ETechZone/Smart-Power-Bank/README.md

# Smart-Power-Bank
my current project in reewo
