ETechZone/Smart-Power-Bank/supporting_docs/F28027_PCBfiles/Station Lower.pdf

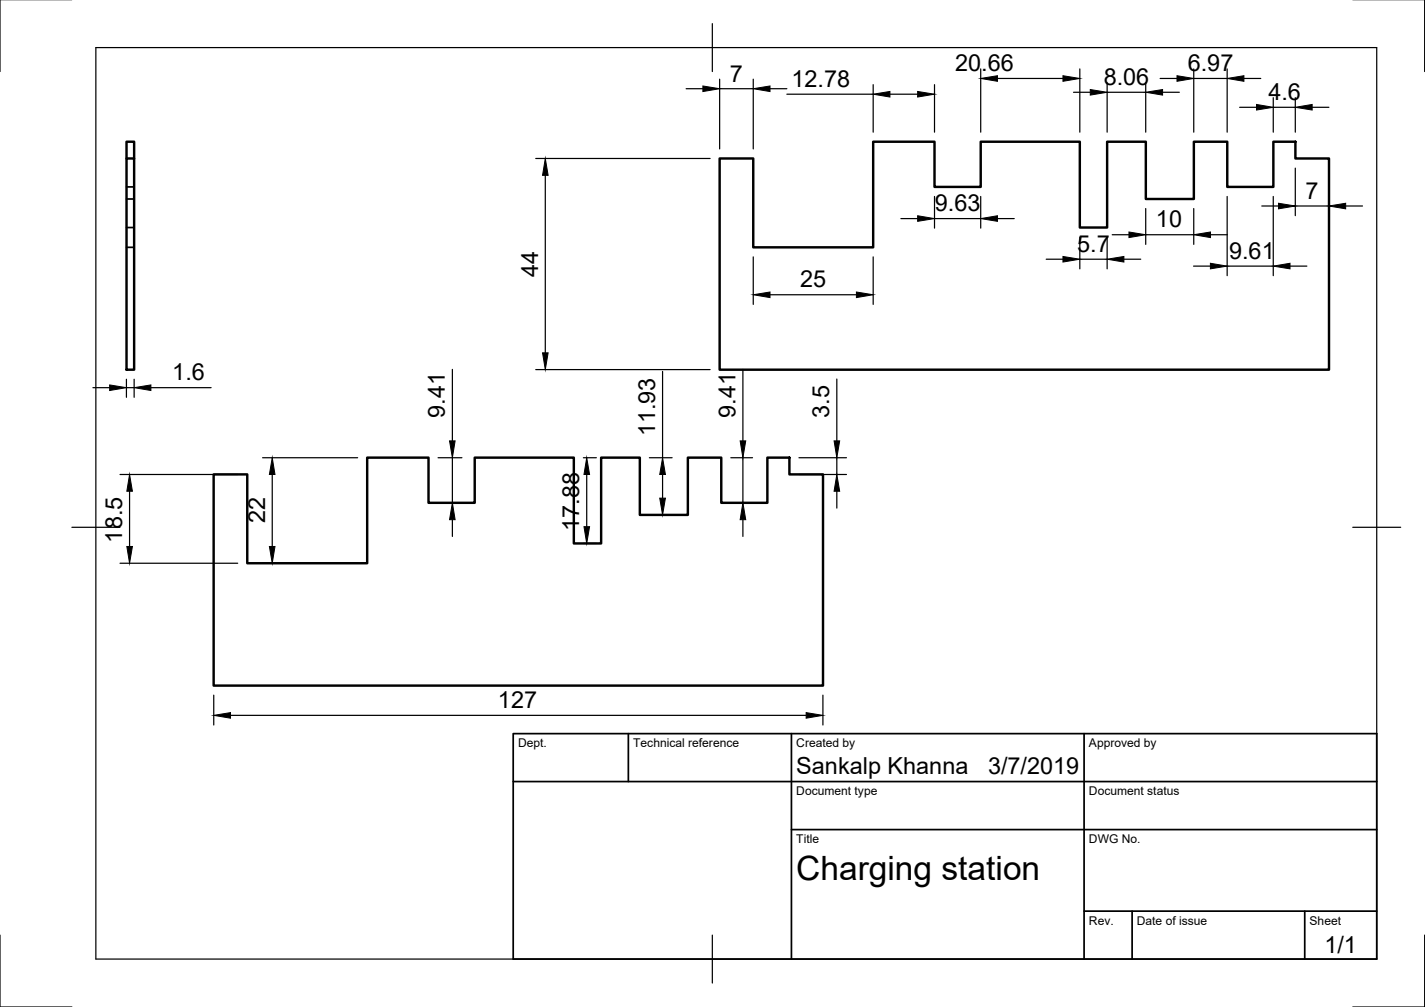
[picture p11: page 1]

Dept. | Technical reference | Created by Sankalp Khanna 3/7/2019 | Approved by

Document type | Document status

Title Charging station | DWG No.

Rev. | Date of issue | Sheet 1/1
