ETechZone/Smart-Power-Bank/PCBfiles/Top PCB.brd

## EAGLE design PCBfiles/Top PCB.brd (2019-07-17)

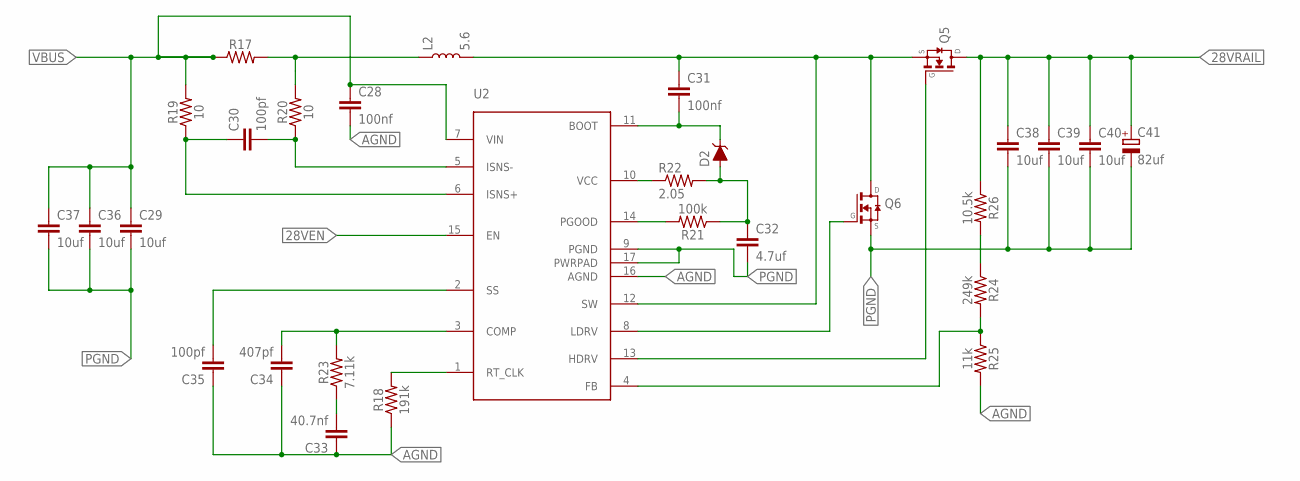
[picture p12: schematic Top PCB.sch, sheet 1]

Parts:
C28, C31: 100nf; C0402K
C29, C36, C37, C38, C39, C40: 10uf; C0805K
C30, C35: 100pf; C0402K
C32: 4.7uf; C0402K
C33: 40.7nf; C0402K
C34: 407pf; C0402K
C41: 82uf; CAPAE830X1040
D2: SS24FL; SODFL3617X108
L2: 5.6; RESM7275X700
Q5, Q6: SIS184DN-T1-GE3
R17: LRMAM2512-R0035FT4; RESC6432X90
R18: 191k; 0402
R19, R20: 10; 0402
R21: 100k; 0402
R22: 2.05; R0603
R23: 7.11k; 0402
R24: 249k; 0402
R25: 11k; 0402
R26: 10.5k; 0402
U2: TPS43061; QFN50P300X300X100-17T80X120

Connections:
28VEN: U2.15 (EN)
28VRAIL: C38.1, C39.1, C40.1, C41.1 (+), Q5.P$5 (D), Q5.P$6 (D), Q5.P$7 (D), Q5.P$8 (D), Q5.P$9 (D), R26.1; also elsewhere on the board
AGND: C28.2, C33.1, C34.1, C35.1, R18.1, R25.2, U2.16 (AGND)
unnamed: C31.1, L2.2, Q5.P$1 (S), Q5.P$2 (S), Q5.P$3 (S), Q6.P$5 (D), Q6.P$6 (D), Q6.P$7 (D), Q6.P$8 (D), Q6.P$9 (D), U2.12 (SW)
unnamed: R24.1, R26.2
unnamed: L2.1, R17.2, R20.2
unnamed: C30.1, R19.1, U2.6 (ISNS+)
unnamed: C30.2, R20.1, U2.5 (ISNS-)
unnamed: C31.2, D2.1 (C), U2.11 (BOOT)
unnamed: C32.1, D2.2 (A), R21.1, R22.2
unnamed: R21.2, U2.14 (PGOOD)
unnamed: R22.1, U2.10 (VCC)
unnamed: R18.2, U2.1 (RT_CLK)
unnamed: Q5.P$4 (G), U2.13 (HDRV)
unnamed: Q6.P$4 (G), U2.8 (LDRV)
unnamed: R24.2, R25.1, U2.4 (FB)
unnamed: C34.2, R23.2, U2.3 (COMP)
unnamed: C33.2, R23.1
unnamed: C35.2, U2.2 (SS)
PGND: C29.2, C32.2, C36.2, C37.2, C38.2, C39.2, C40.2, C41.2 (-), Q6.P$1 (S), Q6.P$2 (S), Q6.P$3 (S), U2.9 (PGND), U2.17 (PWRPAD); also elsewhere on the board
VBUS: C28.1, C29.1, C36.1, C37.1, R17.1, R19.2, U2.7 (VIN)

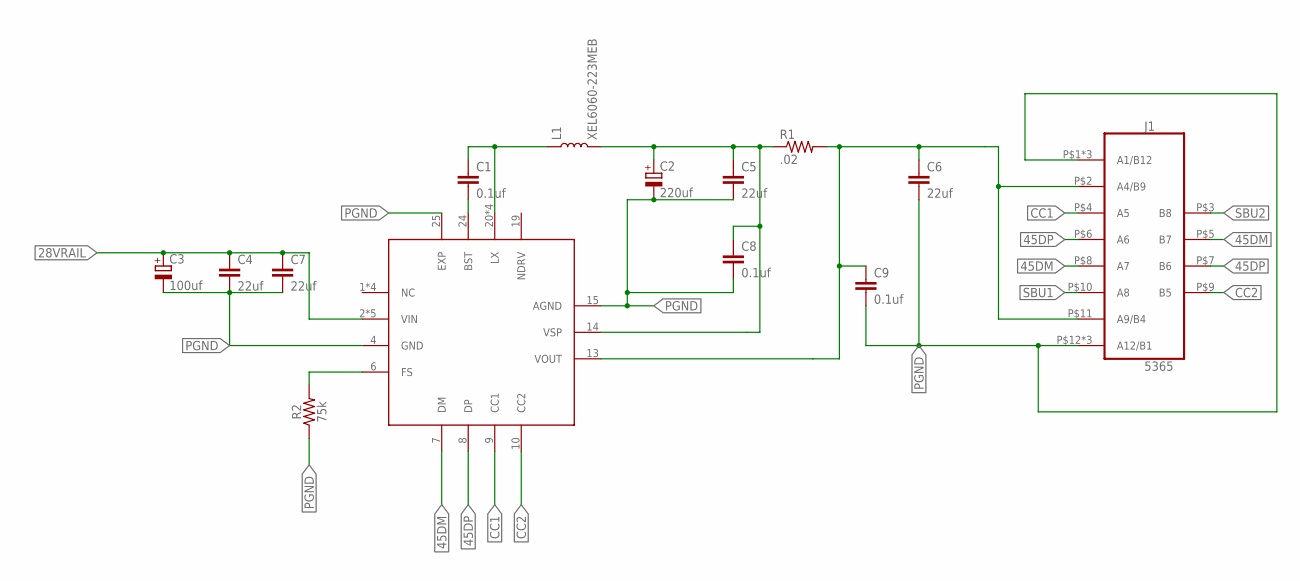
[picture p13: schematic Top PCB.sch, sheet 2]

Parts:
C1, C8, C9: 0.1uf; C0805K
C2: 220uf; CAPAE830X1040
C3: 100uf; CAPAE830X1040
C4, C5, C6, C7: 22uf; C0805K
J1: 5365
L1: XEL6060-223MEB; RESM6365X610
R1: .02; R0805
R2: 75k; 0402
U1: IP6518; QFN50P400X400X80-25T250

Connections:
28VRAIL: C3.1 (+), C4.1, C7.1, U1.2 (VIN), U1.3 (VIN), U1.16 (VIN), U1.17 (VIN), U1.18 (VIN); also elsewhere on the board
45DM: J1.P$5 (B7), J1.P$8 (A7), U1.7 (DM)
45DP: J1.P$6 (A6), J1.P$7 (B6), U1.8 (DP)
CC1: J1.P$4 (A5), U1.9 (CC1)
CC2: J1.P$9 (B5), U1.10 (CC2)
unnamed: C1.1, L1.1, U1.20 (LX), U1.21 (LX), U1.22 (LX), U1.23 (LX)
unnamed: C1.2, U1.24 (BST)
unnamed: C2.1 (+), C5.1, C8.1, L1.2, R1.1, U1.14 (VSP)
unnamed: C6.1, C9.1, J1.P$2 (A4/B9), J1.P$11 (A9/B4), R1.2, U1.13 (VOUT)
unnamed: R2.2, U1.6 (FS)
PGND: C2.2 (-), C3.2 (-), C4.2, C5.2, C6.2, C7.2, C8.2, C9.2, J1.P$1 (A1/B12), J1.P$12 (A12/B1), J1.P$13 (A1/B12), J1.P$14 (A12/B1), J1.P$15 (A1/B12), J1.P$16 (A12/B1), R2.1, U1.4 (GND), U1.15 (AGND), U1.25 (EXP); also elsewhere on the board
SBU1: J1.P$10 (A8)
SBU2: J1.P$3 (B8)

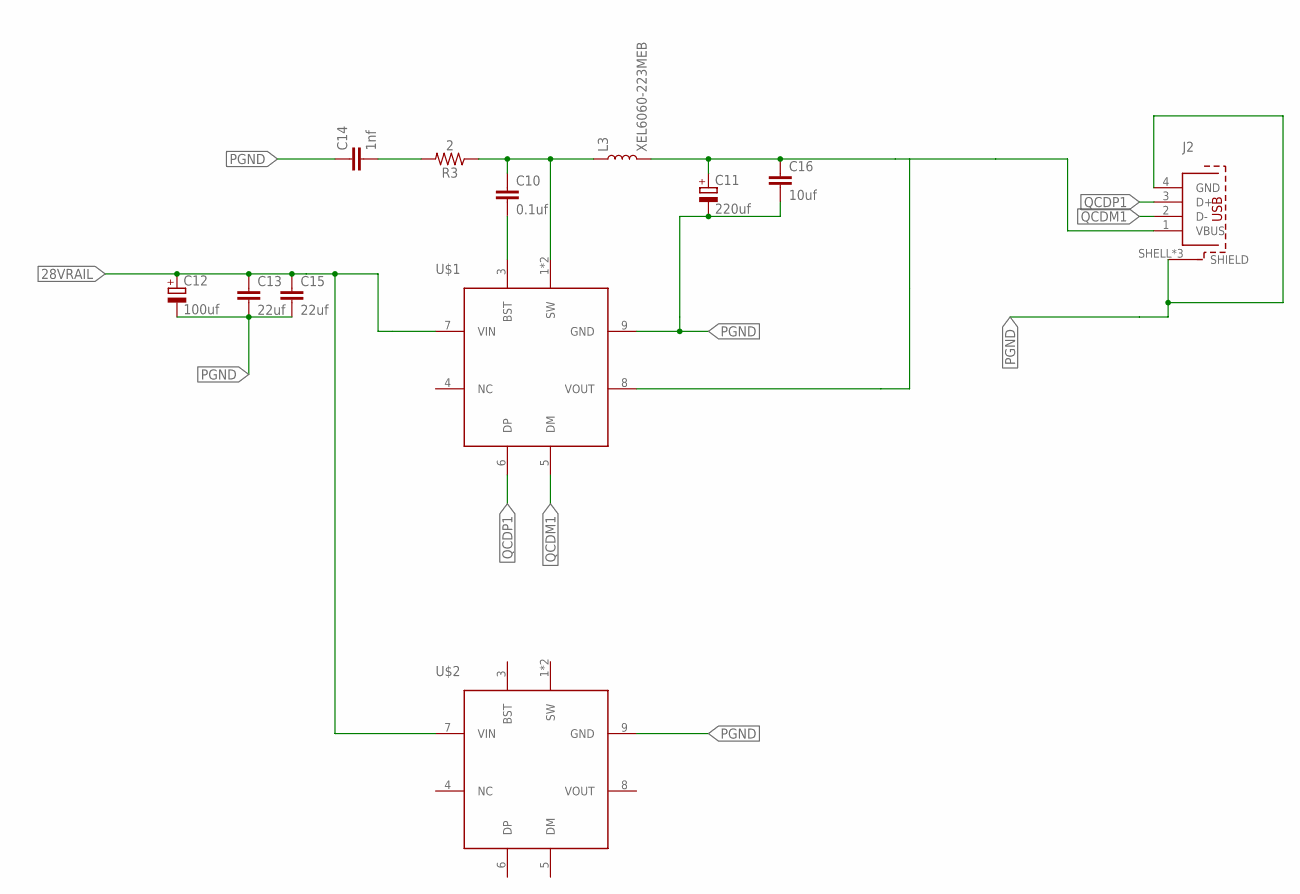
[picture p14: schematic Top PCB.sch, sheet 3]

Parts:
C10: 0.1uf; C0805K
C11: 220uf; CAPAE830X1040
C12: 100uf; CAPAE830X1040
C13, C15: 22uf; C0805K
C14: 1nf; C0402K
C16: 10uf; C0805K
J2: 614004184726
L3: XEL6060-223MEB; RESM6365X610
R3: 2; 0402
U$1, U$2: IP6505; SOIC127P600X165-9T209

Connections:
28VRAIL: C12.1 (+), C13.1, C15.1, U$1.7 (VIN), U$2.7 (VIN); also elsewhere on the board
unnamed: C10.1, L3.1, R3.1, U$1.1 (SW), U$1.2 (SW)
unnamed: C10.2, U$1.3 (BST)
unnamed: C14.2, R3.2
unnamed: J2.1 (VBUS), U$1.8 (VOUT)
unnamed: C11.1 (+), C16.1, L3.2
PGND: C11.2 (-), C12.2 (-), C13.2, C14.1, C15.2, C16.2, J2.4 (GND), J2.SHELL (SHIELD), J2.SHELL1 (SHIELD), J2.SHELL2 (SHIELD), U$1.9 (GND), U$2.9 (GND); also elsewhere on the board
QCDM1: J2.2 (D-), U$1.5 (DM)
QCDP1: J2.3 (D+), U$1.6 (DP)

Board: 2 copper layers, 55 parts (0 on the bottom side), 36 nets, no tracks yet.
