ETechZone/Smart-Power-Bank/PCBfiles/B PCB.brd

## EAGLE design PCBfiles/B PCB.brd (2019-07-17)

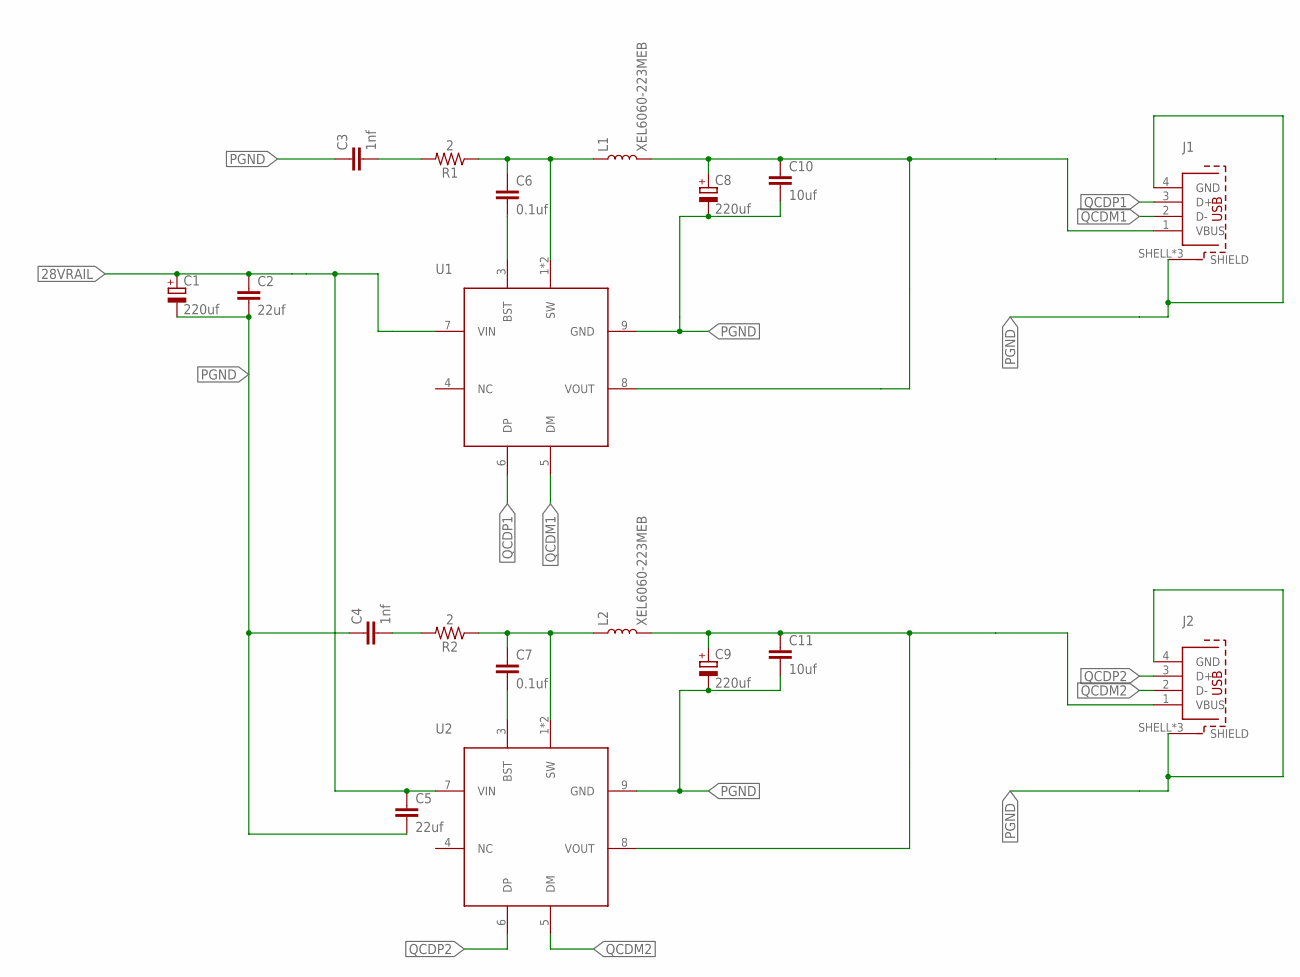
[picture p15: schematic B PCB.sch, sheet 1]

Parts:
C1: 220uf; CAPAE830X1040
C2, C5: 22uf; C0805K
C3, C4: 1nf; C0402K
C6, C7: 0.1uf; C0805K
C8, C9: 220uf; CAPAE660X800
C10, C11: 10uf; C0805K
J1, J2: 614004184726
L1, L2: XEL6060-223MEB; RESM6365X610
R1, R2: 2; 0402
U1, U2: IP6505; SOIC127P600X165-9T209

Connections:
28VRAIL: C1.1 (+), C2.1, C5.1, U1.7 (VIN), U2.7 (VIN); also elsewhere on the board
unnamed: C7.1, L2.1, R2.1, U2.1 (SW), U2.2 (SW)
unnamed: C7.2, U2.3 (BST)
unnamed: C6.1, L1.1, R1.1, U1.1 (SW), U1.2 (SW)
unnamed: C9.1 (+), C11.1, J2.1 (VBUS), L2.2, U2.8 (VOUT)
unnamed: C4.2, R2.2
unnamed: C6.2, U1.3 (BST)
unnamed: C3.2, R1.2
unnamed: C8.1 (+), C10.1, J1.1 (VBUS), L1.2, U1.8 (VOUT)
PGND: C1.2 (-), C2.2, C3.1, C4.1, C5.2, C8.2 (-), C9.2 (-), C10.2, C11.2, J1.4 (GND), J1.SHELL (SHIELD), J1.SHELL1 (SHIELD), J1.SHELL2 (SHIELD), J2.4 (GND), J2.SHELL (SHIELD), J2.SHELL1 (SHIELD), J2.SHELL2 (SHIELD), U1.9 (GND), U2.9 (GND); also elsewhere on the board
QCDM1: J1.2 (D-), U1.5 (DM)
QCDM2: J2.2 (D-), U2.5 (DM)
QCDP1: J1.3 (D+), U1.6 (DP)
QCDP2: J2.3 (D+), U2.6 (DP)

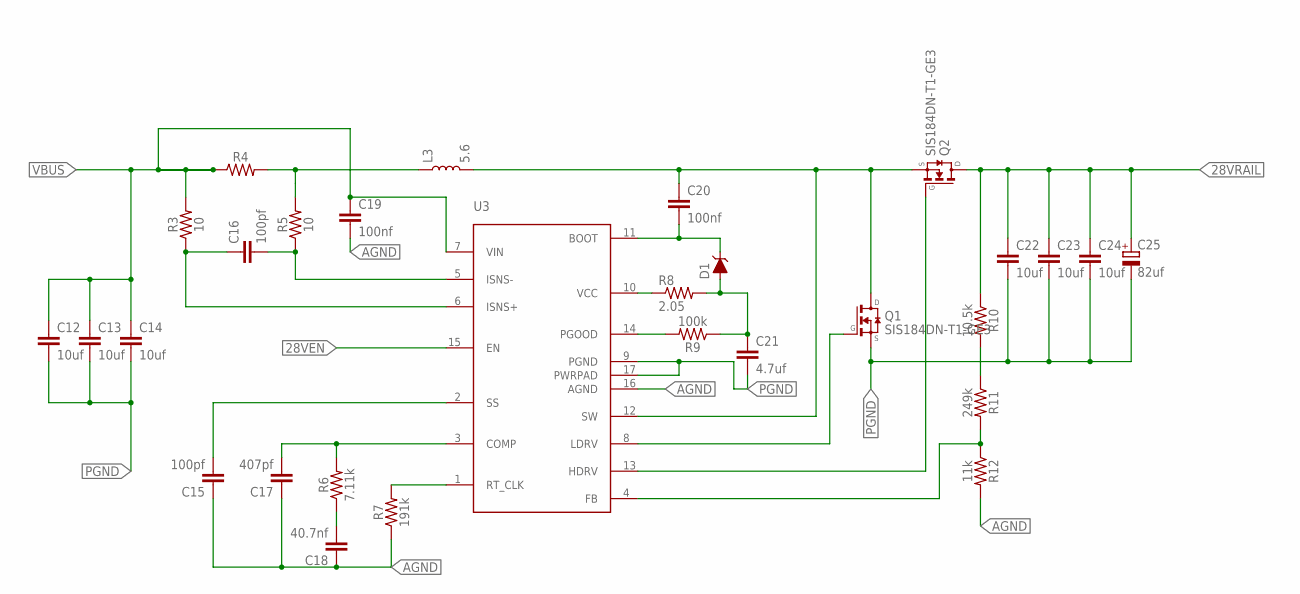
[picture p16: schematic B PCB.sch, sheet 2]

Parts:
C12, C13, C14, C22, C23, C24: 10uf; C0805K
C15, C16: 100pf; C0402K
C17: 407pf; C0402K
C18: 40.7nf; C0402K
C19, C20: 100nf; C0402K
C21: 4.7uf; C0402K
C25: 82uf; CAPAE660X800
D1: SS24FL; SODFL3617X108
L3: 5.6; RESM7275X700
Q1, Q2: SIS184DN-T1-GE3
R3, R5: 10; 0402
R4: LRMAM2512-R0035FT4; RESC6432X90
R6: 7.11k; 0402
R7: 191k; 0402
R8: 2.05; R0603
R9: 100k; 0402
R10: 10.5k; 0402
R11: 249k; 0402
R12: 11k; 0402
U3: TPS43061; QFN50P300X300X100-17T80X120

Connections:
28VEN: U3.15 (EN)
28VRAIL: C22.1, C23.1, C24.1, C25.1 (+), Q2.P$5 (D), Q2.P$6 (D), Q2.P$7 (D), Q2.P$8 (D), Q2.P$9 (D), R10.1; also elsewhere on the board
AGND: C15.1, C17.1, C18.1, C19.2, R7.1, R12.2, U3.16 (AGND)
unnamed: C20.1, L3.2, Q1.P$5 (D), Q1.P$6 (D), Q1.P$7 (D), Q1.P$8 (D), Q1.P$9 (D), Q2.P$1 (S), Q2.P$2 (S), Q2.P$3 (S), U3.12 (SW)
unnamed: R10.2, R11.1
unnamed: L3.1, R4.2, R5.2
unnamed: C16.1, R3.1, U3.6 (ISNS+)
unnamed: C16.2, R5.1, U3.5 (ISNS-)
unnamed: C20.2, D1.1 (C), U3.11 (BOOT)
unnamed: C21.1, D1.2 (A), R8.2, R9.1
unnamed: R9.2, U3.14 (PGOOD)
unnamed: R8.1, U3.10 (VCC)
unnamed: R7.2, U3.1 (RT_CLK)
unnamed: Q2.P$4 (G), U3.13 (HDRV)
unnamed: Q1.P$4 (G), U3.8 (LDRV)
unnamed: R11.2, R12.1, U3.4 (FB)
unnamed: C17.2, R6.2, U3.3 (COMP)
unnamed: C18.2, R6.1
unnamed: C15.2, U3.2 (SS)
PGND: C12.2, C13.2, C14.2, C21.2, C22.2, C23.2, C24.2, C25.2 (-), Q1.P$1 (S), Q1.P$2 (S), Q1.P$3 (S), U3.9 (PGND), U3.17 (PWRPAD); also elsewhere on the board
VBUS: C12.1, C13.1, C14.1, C19.1, R3.2, R4.1, U3.7 (VIN)

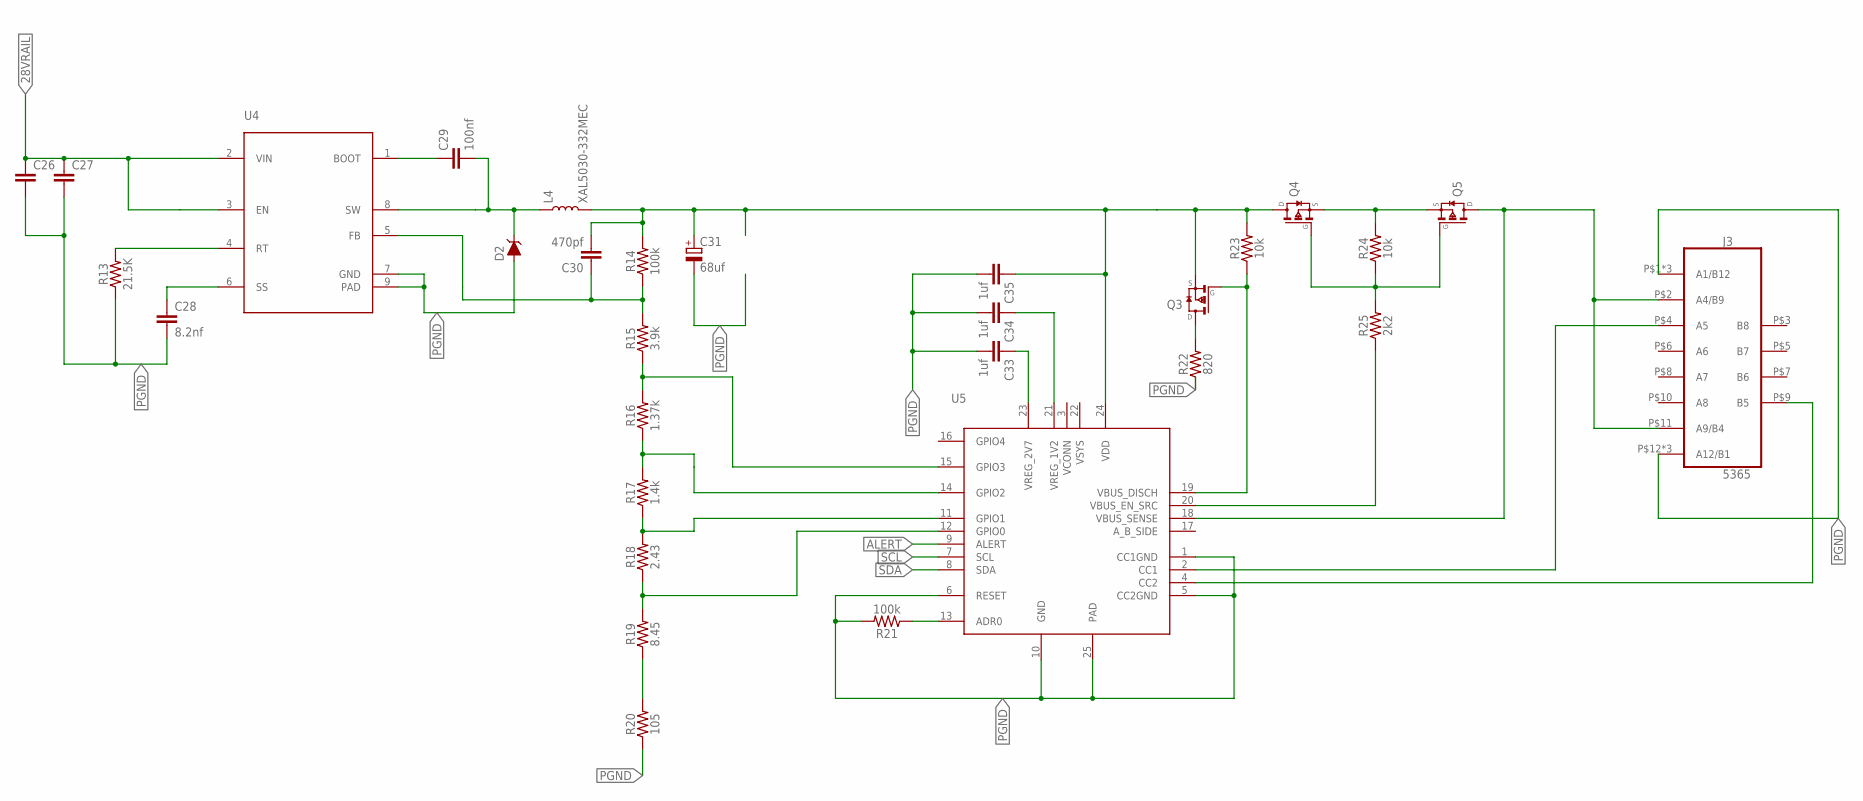
[picture p17: schematic B PCB.sch, sheet 3]

Parts:
C26, C27: C-EUC1210; C1210
C28: 8.2nf; C0402K
C29: 100nf; C0402K
C30: 470pf; C0402K
C31: 68uf; CAPAE830X1040
C33, C34, C35: 1uf; C0402K
D2: B560C-13-F; DIOM6859X250
J3: 5365
L4: XAL5030-332MEC; INDM5355X310
Q3: STR2P3LLH6; SOT95P280X125-3
Q4, Q5: STL9P3LLH6; SON65P330X330X80-8
R13: 21.5K; 0402
R14, R21: 100k; 0402
R15: 3.9k; 0402
R16: 1.37k; 0402
R17: 1.4k; 0402
R18: 2.43; 0402
R19: 8.45; 0402
R20: 105; 0402
R22: 820; 0402
R23, R24: 10k; 0402
R25: 2k2; 0402
U4: LMR14050; SOIC127P600X170-9T240X260
U5: STUSB4700; QFN50P400X400X100-25T270

Connections:
28VRAIL: C26.1, C27.1, U4.2 (VIN), U4.3 (EN); also elsewhere on the board
ALERT: U5.9 (ALERT)
unnamed: C33.1, U5.23 (VREG_2V7)
unnamed: C34.1, U5.21 (VREG_1V2)
unnamed: Q3.3 (D), R22.2
unnamed: C30.1, R14.1, R15.2, U4.5 (FB)
unnamed: R15.1, R16.2, U5.15 (GPIO3)
unnamed: R16.1, R17.2, U5.14 (GPIO2)
unnamed: R17.1, R18.2, U5.11 (GPIO1)
unnamed: R18.1, R19.2, U5.12 (GPIO0)
unnamed: R19.1, R20.2
unnamed: R21.1, U5.13 (ADR0)
unnamed: C29.1, U4.1 (BOOT)
unnamed: C29.2, D2.1 (C), L4.1, U4.8 (SW)
unnamed: C28.1, U4.6 (SS)
unnamed: Q4.1 (S), Q4.2 (S), Q4.3 (S), Q5.1 (S), Q5.2 (S), Q5.3 (S), R24.2
unnamed: R13.2, U4.4 (RT)
unnamed: C30.2, C31.1 (+), C35.1, L4.2, Q3.2 (S), Q4.5 (D), Q4.6 (D), Q4.7 (D), R14.2, R23.2, U5.24 (VDD)
unnamed: Q3.1 (G), R23.1, U5.19 (VBUS_DISCH)
unnamed: Q4.4 (G), Q5.4 (G), R24.1, R25.2
unnamed: R25.1, U5.20 (VBUS_EN_SRC)
unnamed: J3.P$2 (A4/B9), J3.P$11 (A9/B4), Q5.5 (D), Q5.6 (D), Q5.7 (D), U5.18 (VBUS_SENSE)
unnamed: J3.P$4 (A5), U5.2 (CC1)
unnamed: J3.P$9 (B5), U5.4 (CC2)
PGND: C26.2, C27.2, C28.2, C31.2 (-), C33.2, C34.2, C35.2, D2.2 (A), J3.P$1 (A1/B12), J3.P$12 (A12/B1), J3.P$13 (A1/B12), J3.P$14 (A12/B1), J3.P$15 (A1/B12), J3.P$16 (A12/B1), R13.1, R20.1, R21.2, R22.1, U4.7 (GND), U4.9 (PAD), U5.1 (CC1GND), U5.5 (CC2GND), U5.6 (RESET), U5.10 (GND), U5.25 (PAD); also elsewhere on the board
SCL: U5.7 (SCL)
SDA: U5.8 (SDA)

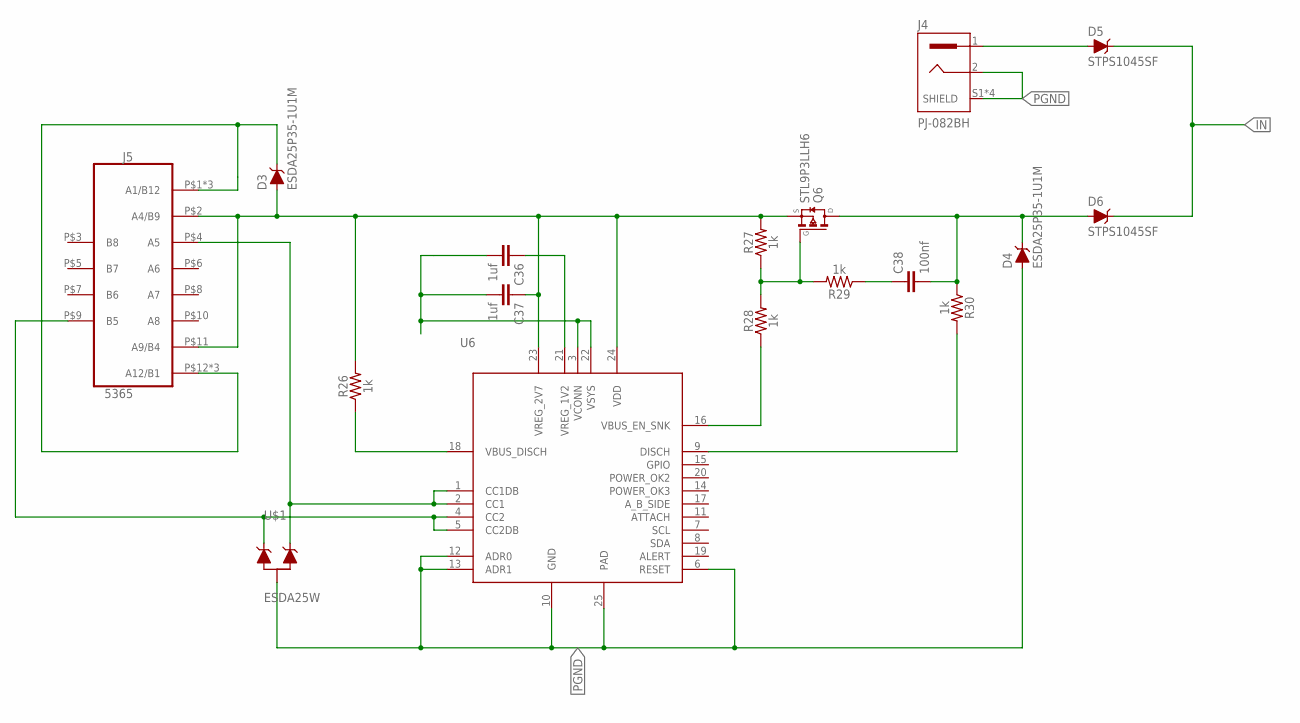
[picture p18: schematic B PCB.sch, sheet 4]

Parts:
C36, C37: 1uf; C0402K
C38: 100nf; C0402K
D3, D4: ESDA25P35-1U1M; DIODFN160X100X60-2
D5, D6: STPS1045SF; DIODFN650X460X120-3
J4: PJ-082BH; CUI_PJ-082BH
J5: 5365
Q6: STL9P3LLH6; SON65P330X330X80-8
R26, R27, R28, R29, R30: 1k; 0402
U6: STUSB4500; QFN50P400X400X100-25T270
U$1: ESDA25W; SOT65P210X110-3

Connections:
IN: D5.3 (C), D6.3 (C)
unnamed: D5.1 (A), D5.2 (A), J4.1
unnamed: D3.1 (C), J5.P$1 (A1/B12), J5.P$12 (A12/B1), J5.P$13 (A1/B12), J5.P$14 (A12/B1), J5.P$15 (A1/B12), J5.P$16 (A12/B1)
unnamed: J5.P$4 (A5), U6.1 (CC1DB), U6.2 (CC1), U$1.2 (C2)
unnamed: J5.P$9 (B5), U6.4 (CC2), U6.5 (CC2DB), U$1.1 (C1)
unnamed: R26.1, U6.18 (VBUS_DISCH)
unnamed: C36.1, U6.21 (VREG_1V2)
unnamed: C36.2, C37.2, U6.3 (VCONN), U6.22 (VSYS)
unnamed: C37.1, D3.2 (A), J5.P$2 (A4/B9), J5.P$11 (A9/B4), Q6.1 (S), Q6.2 (S), Q6.3 (S), R26.2, R27.2, U6.23 (VREG_2V7), U6.24 (VDD)
unnamed: Q6.4 (G), R27.1, R28.2, R29.2
unnamed: R28.1, U6.16 (VBUS_EN_SNK)
unnamed: R30.2, U6.9 (DISCH)
unnamed: C38.1, R29.1
unnamed: C38.2, D4.1 (C), D6.1 (A), D6.2 (A), Q6.5 (D), Q6.6 (D), Q6.7 (D), R30.1
PGND: D4.2 (A), J4.2, J4.S1 (SHIELD), J4.S2 (SHIELD), J4.S3 (SHIELD), J4.S4 (SHIELD), U6.6 (RESET), U6.10 (GND), U6.12 (ADR0), U6.13 (ADR1), U6.25 (PAD), U$1.3 (A); also elsewhere on the board

Board: 4 copper layers, 95 parts (0 on the bottom side), 68 nets, no tracks yet.
