ETechZone/Smart-Power-Bank/PCBfiles/Conn_pcb5.brd

## EAGLE design PCBfiles/Conn_pcb5.brd (2019-07-17)

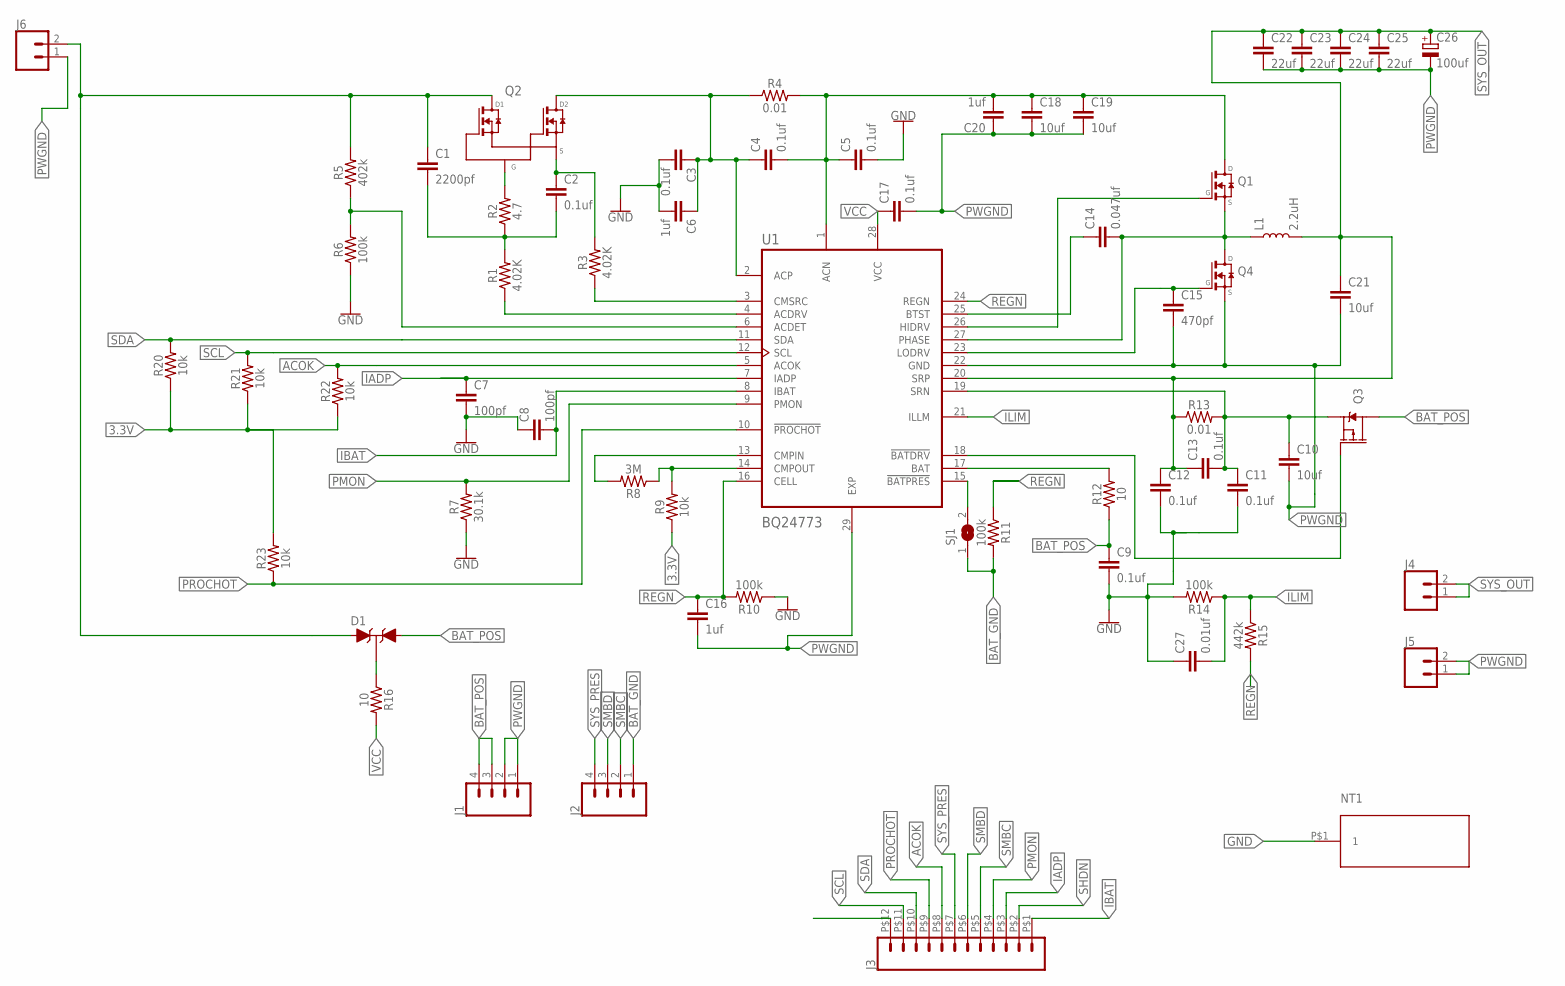
[picture p19: schematic Conn_pcb5.sch, sheet 1]

Parts:
C1: 2200pf; CAPC1005X50
C2, C3, C4, C5, C9, C11, C12, C13, C17: 0.1uf; CAPC1005X50
C6, C16, C20: 1uf; CAPC1005X50
C7, C8: 100pf; CAPC1005X50
C10, C18, C19, C21: 10uf; C0805K
C14: 0.047uf; CAPC1005X50
C15: 470pf; CAPC1005X50
C22, C23, C24, C25: 22uf; C1206
C26: 100uf; CAPAE1030X800
C27: 0.01uf; CAPC1005X50
D1: BAT54C-7-F; SOT95P235X110-3
J1, J2: CONN_041.3; 1X04_NO_SILK_1.3
J3: 62674-121121ALF
J4, J5, J6: CONN_021.4HOLE; 1X02_1.4HOLE
L1: 2.2uH; RESM6365X610
NT1: NET_TIE
Q1, Q4: CSD17308Q3; SON65P330X330X110-8
Q2: CSD87312Q3EVSON; QFN65P330X330X100-12
Q3: CSD25402Q3A
R1, R3: 4.02K; 0402
R2: 4.7; 0402
R4, R13: 0.01; 1206
R5: 402k; 0402
R6, R10, R11, R14: 100k; 0402
R7: 30.1k; 0402
R8: 3M; 0402
R9, R20, R21, R22, R23: 10k; 0402
R12, R16: 10; 0402
R15: 442k; 0402
SJ1: SJ
U1: BQ24773; QFN40P400X400X80-29T240

Connections:
3.3V: R9.1, R20.1, R21.1, R22.1, R23.2; also elsewhere on the board
ACOK: J3.P$8 (8), R22.2, U1.5 (ACOK)
BAT_GND: J2.1, R11.2, SJ1.1
BAT_POS: C9.1, D1.2 (A2), J1.3, J1.4, Q3.1 (D), Q3.2 (D), Q3.3 (D), R12.1; also elsewhere on the board
GND: C3.2, C5.2, C6.2, C7.2, C8.1, C9.2, C11.2, C12.2, C27.1, NT1.P$1, R6.1, R7.1, R10.1, R14.2
IADP: C7.1, J3.P$3 (3), U1.7 (IADP)
IBAT: C8.2, J3.P$1 (1), U1.8 (IBAT)
ILIM: C27.2, R14.1, R15.1, U1.21 (ILLM)
unnamed: R1.1, U1.4 (ACDRV)
unnamed: C1.2, C2.2, R1.2, R2.1
unnamed: Q2.5 (G), R2.2
unnamed: C1.1, D1.1 (A1), J6.2, Q2.1 (D1), Q2.3 (D1), Q2.4 (D1), R5.2
unnamed: R5.1, R6.2, U1.6 (ACDET)
unnamed: C4.2, C5.1, C18.1, C19.1, C20.2, Q1.5 (D), Q1.6 (D), Q1.7 (D), Q1.8 (D), R4.2, U1.1 (ACN)
unnamed: C2.1, Q2.9 (S), Q2.9.1 (S), Q2.9.2 (S), Q2.9.3 (S), Q2.9.4 (S), R3.2
unnamed: R3.1, U1.3 (CMSRC)
unnamed: C3.1, C4.1, C6.1, Q2.6 (D2), Q2.7 (D2), Q2.8 (D2), R4.1, U1.2 (ACP)
unnamed: R8.2, U1.13 (CMPIN)
unnamed: R8.1, R9.2, U1.14 (CMPOUT)
unnamed: R12.2, U1.17 (BAT)
unnamed: Q3.4 (G), U1.18 (!BATDRV)
unnamed: C10.1, C11.1, C13.2, Q3.5 (S), Q3.6 (S), Q3.7 (S), Q3.8 (S), Q3.9 (S), R13.2, U1.19 (SRN)
unnamed: C15.1, Q4.4 (G), U1.23 (LODRV)
unnamed: SJ1.2, U1.15 (!BATPRES)
unnamed: D1.3 (K), R16.1
unnamed: C14.2, L1.1, Q1.1 (S), Q1.2 (S), Q1.3 (S), Q4.5 (D), Q4.6 (D), Q4.7 (D), Q4.8 (D), U1.27 (PHASE)
unnamed: C14.1, U1.25 (BTST)
unnamed: Q1.4 (G), U1.26 (HIDRV)
PMON: J3.P$4 (4), R7.2, U1.9 (PMON)
PROCHOT: J3.P$9 (9), R23.1, U1.10 (!PROCHOT)
PWGND: C10.2, C15.2, C16.2, C17.2, C18.2, C19.2, C20.1, C21.2, C22.2, C23.2, C24.2, C25.2, C26.2 (-), J1.1, J1.2, J5.1, J5.2, J6.1, Q4.1 (S), Q4.2 (S), Q4.3 (S), U1.22 (GND), U1.29 (EXP); also elsewhere on the board
REGN: C16.1, R10.2, R11.1, R15.2, U1.16 (CELL), U1.24 (REGN)
SCL: J3.P$11 (11), R21.2, U1.12 (SCL)
SDA: J3.P$10 (10), R20.2, U1.11 (SDA)
SHDN: J3.P$2 (2); also elsewhere on the board
SMBC: J2.2, J3.P$5 (5)
SMBD: J2.3, J3.P$6 (6)
SYS_OUT: C12.1, C13.1, C21.1, C22.1, C23.1, C24.1, C25.1, C26.1 (+), J4.1, J4.2, L1.2, R13.1, U1.20 (SRP); also elsewhere on the board
SYS_PRES: J2.4, J3.P$7 (7)
VCC: C17.1, R16.2, U1.28 (VCC)

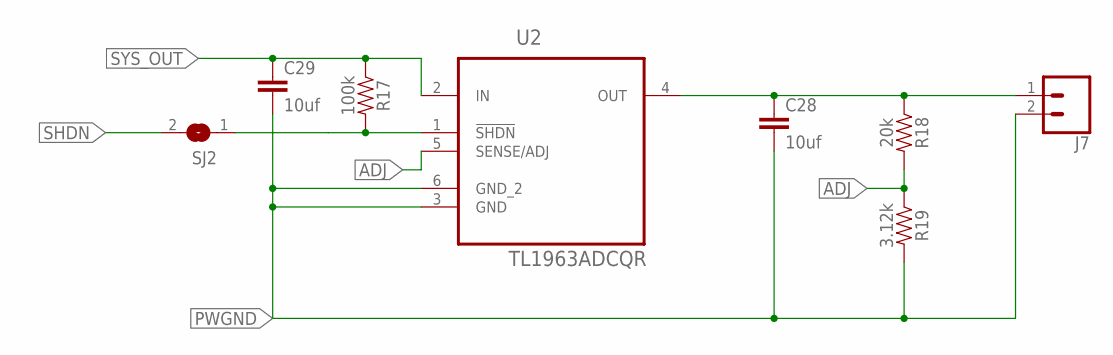
[picture p20: schematic Conn_pcb5.sch, sheet 2]

Parts:
C28, C29: 10uf; C0805K
J7: CONN_02; 1X02
R17: 100k; 0402
R18: 20k; 0402
R19: 3.12k; 0402
SJ2: SJ
U2: TL1963ADCQR; SOT127P706X180-6

Connections:
ADJ: R18.2, R19.1, U2.5 (SENSE/ADJ)
unnamed: C28.1, J7.1, R18.1, U2.4 (OUT)
unnamed: R17.2, SJ2.1, U2.1 (!SHDN)
PWGND: C28.2, C29.2, J7.2, R19.2, U2.3 (GND), U2.6 (GND_2); also elsewhere on the board
SHDN: SJ2.2; also elsewhere on the board
SYS_OUT: C29.1, R17.1, U2.2 (IN); also elsewhere on the board

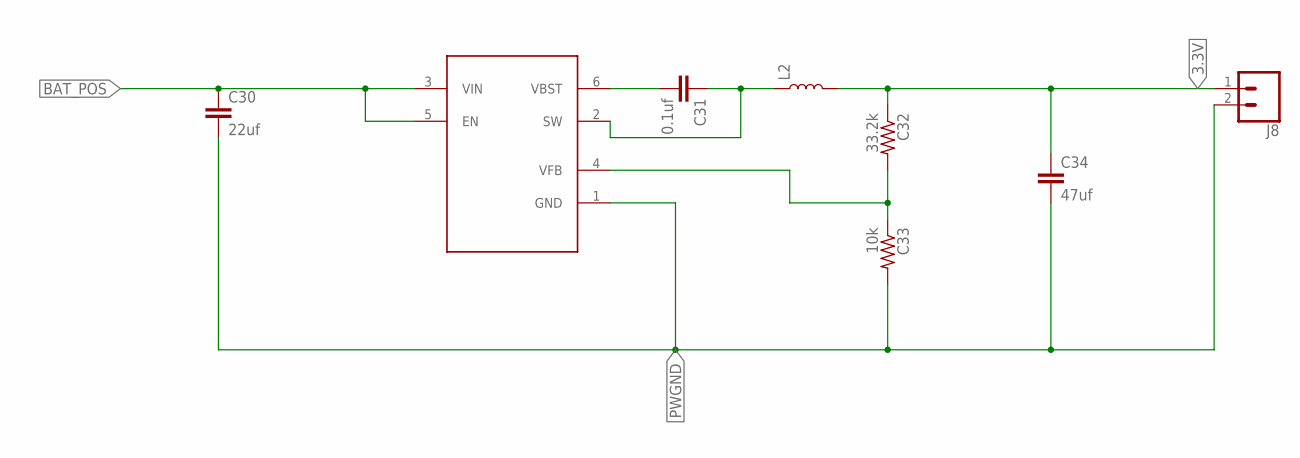
[picture p21: schematic Conn_pcb5.sch, sheet 3]

Parts:
C30: 22uf; C1206
C31: 0.1uf; CAPC1005X50
C32: 33.2k; R0805
C33: 10k; R0603
C34: 47uf; C1206K
J8: CONN_02; 1X02
L2: ASPI-4030S-3R3M-T; INDDFN400X400X300-2
U3: TPS561208DDCR; SOT95P280X110-6

Connections:
3.3V: C32.1, C34.1, J8.1, L2.2; also elsewhere on the board
BAT_POS: C30.1, U3.3 (VIN), U3.5 (EN); also elsewhere on the board
unnamed: C31.2, U3.6 (VBST)
unnamed: C31.1, L2.1, U3.2 (SW)
unnamed: C32.2, C33.1, U3.4 (VFB)
PWGND: C30.2, C33.2, C34.2, J8.2, U3.1 (GND); also elsewhere on the board

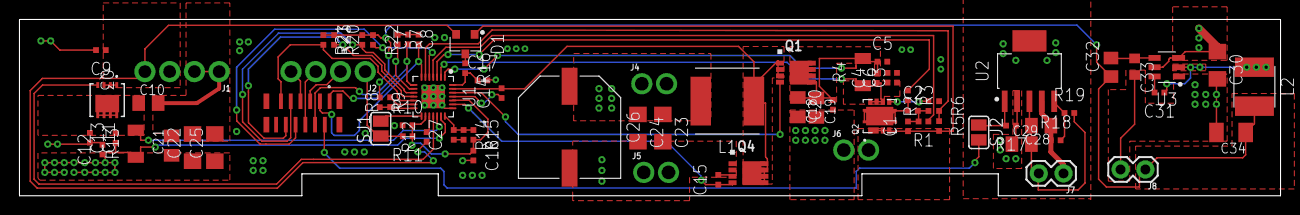
[picture p22: board Conn_pcb5.brd from above]

Board: 4 copper layers, 129.5 x 18.1 mm, 78 parts (1 on the bottom side), 46 nets.
