ETechZone/Smart-Power-Bank/PCBfiles/Top PCB1.brd

## EAGLE design PCBfiles/Top PCB1.brd (2019-07-17)

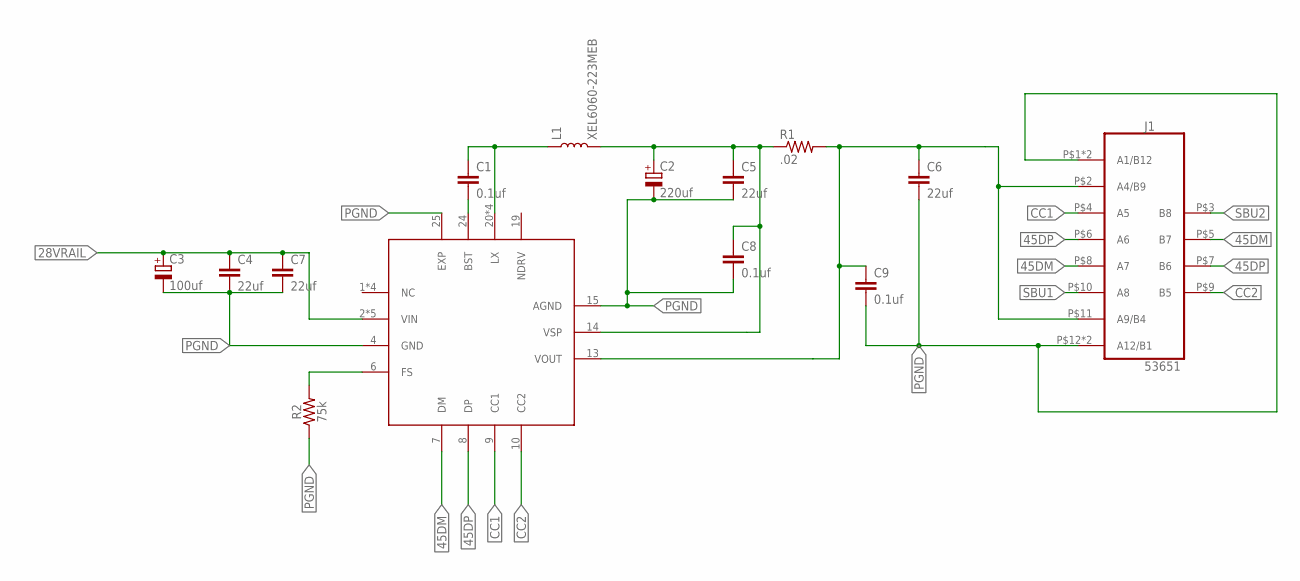
[picture p23: schematic Top PCB1.sch, sheet 1]

Parts:
C1, C8, C9: 0.1uf; C0805K
C2: 220uf; CAPAE660X800
C3: 100uf; CAPAE660X800
C4, C5, C6, C7: 22uf; C0805K
J1: 53651
L1: XEL6060-223MEB; RESM6365X610
R1: .02; R0805
R2: 75k; 0402
U1: IP6518; QFN50P400X400X80-25T250

Connections:
28VRAIL: C3.1 (+), C4.1, C7.1, U1.2 (VIN), U1.3 (VIN), U1.16 (VIN), U1.17 (VIN), U1.18 (VIN)
45DM: J1.P$5 (B7), J1.P$8 (A7), U1.7 (DM)
45DP: J1.P$6 (A6), J1.P$7 (B6), U1.8 (DP)
CC1: J1.P$4 (A5), U1.9 (CC1)
CC2: J1.P$9 (B5), U1.10 (CC2)
unnamed: C1.1, L1.1, U1.20 (LX), U1.21 (LX), U1.22 (LX), U1.23 (LX)
unnamed: C1.2, U1.24 (BST)
unnamed: C2.1 (+), C5.1, C8.1, L1.2, R1.1, U1.14 (VSP)
unnamed: C6.1, C9.1, J1.P$2 (A4/B9), J1.P$11 (A9/B4), R1.2, U1.13 (VOUT)
unnamed: R2.2, U1.6 (FS)
PGND: C2.2 (-), C3.2 (-), C4.2, C5.2, C6.2, C7.2, C8.2, C9.2, J1.P$1 (A1/B12), J1.P$12 (A12/B1), J1.P$13 (A1/B12), J1.P$14 (A12/B1), R2.1, U1.4 (GND), U1.15 (AGND), U1.25 (EXP)
SBU1: J1.P$10 (A8)
SBU2: J1.P$3 (B8)


Parts:
C28, C29: 10uf; C0805K
J7: CONN_02; 1X02
R17: 100k; 0402
R18: 20k; 0402
R19: 3.12k; 0402
SJ2: SJ
U2: TL1963ADCQR; SOT127P706X180-6

Connections:
ADJ: R18.2, R19.1, U2.5 (SENSE/ADJ)
unnamed: C28.1, J7.1, R18.1, U2.4 (OUT)
unnamed: R17.2, SJ2.1, U2.1 (!SHDN)
PWGND: C28.2, C29.2, J7.2, R19.2, U2.3 (GND), U2.6 (GND_2); also elsewhere on the board
SHDN: SJ2.2
SYS_OUT: C29.1, R17.1, U2.2 (IN)

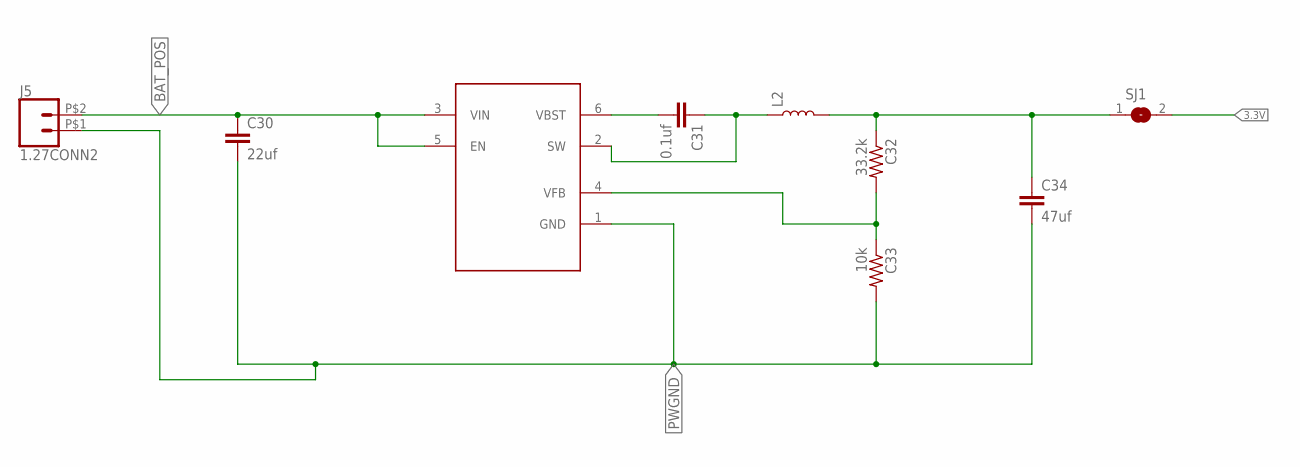
[picture p24: schematic Top PCB1.sch, sheet 3]

Parts:
C30: 22uf; C1206
C31: 0.1uf; CAPC1005X50
C32: 33.2k; R0805
C33: 10k; R0603
C34: 47uf; C1206K
J5: 1.27CONN2; CONN2_1.27
L2: ASPI-4030S-3R3M-T; INDDFN400X400X300-2
SJ1: SJ
U3: TPS561208DDCR; SOT95P280X110-6

Connections:
3.3V: SJ1.2; also elsewhere on the board
BAT_POS: C30.1, J5.P$2 (2), U3.3 (VIN), U3.5 (EN)
unnamed: C32.1, C34.1, L2.2, SJ1.1
unnamed: C31.2, U3.6 (VBST)
unnamed: C31.1, L2.1, U3.2 (SW)
unnamed: C32.2, C33.1, U3.4 (VFB)
PWGND: C30.2, C33.2, C34.2, J5.P$1 (1), U3.1 (GND); also elsewhere on the board
