ETechZone/Smart-Power-Bank/PCBfiles/Top PCB1.brd

## EAGLE design PCBfiles/Top PCB1.brd (continued)

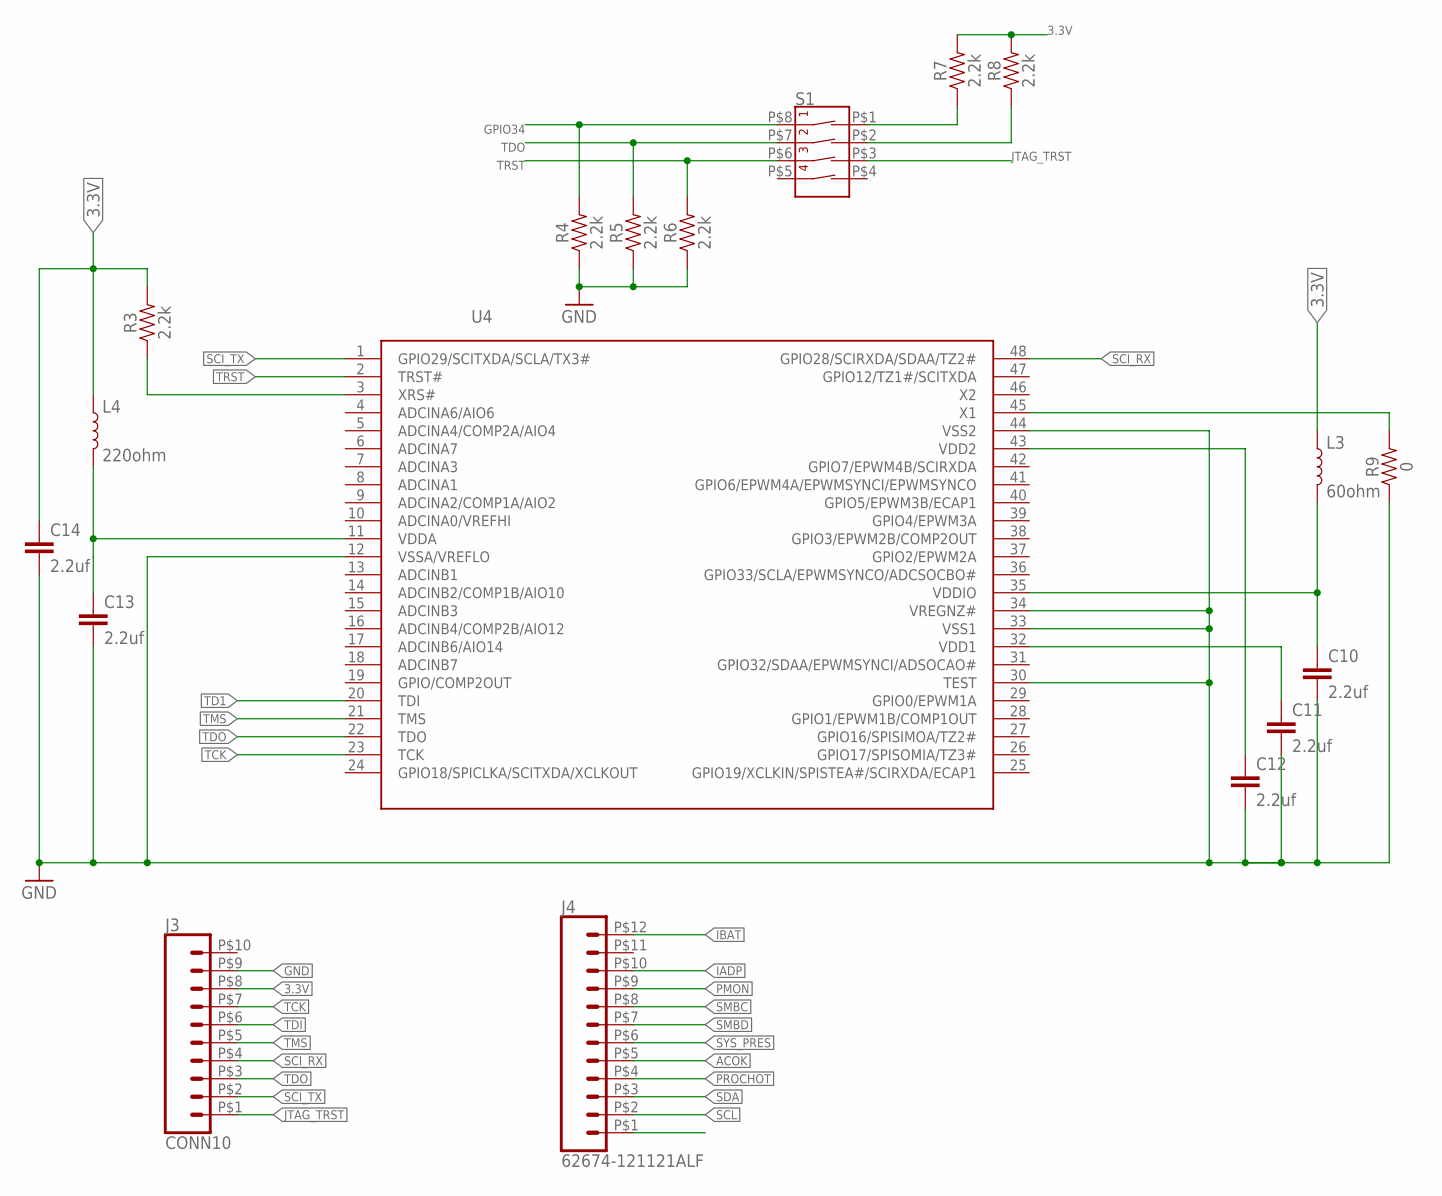
[picture p25: schematic Top PCB1.sch, sheet 4]

Parts:
C10, C11, C12, C13, C14: 2.2uf; C0402K
J3: CONN10; CONN10_1.27
J4: 62674-121121ALF
L3: 60ohm; BEADC1005X50
L4: 220ohm; BEADC1005X50
R3, R4, R5, R6, R7, R8: 2.2k; 0402
R9: 0; 0402
S1: DHN-04-V
U4: TMS320F28027; QFP50P900X900X145-48

Connections:
3.3V: C14.1, J3.P$8 (8), L3.1, L4.1, R3.2, R7.2, R8.2; also elsewhere on the board
ACOK: J4.P$5 (5)
GND: C10.2, C11.2, C12.2, C13.2, C14.2, J3.P$9 (9), R4.1, R5.1, R6.1, R9.1, U4.12 (VSSA/VREFLO), U4.30 (TEST), U4.33 (VSS1), U4.34 (VREGNZ#), U4.44 (VSS2)
GPIO34: R4.2, S1.P$8 (1B)
IADP: J4.P$10 (10)
IBAT: J4.P$12 (12)
JTAG_TRST: J3.P$1 (1), S1.P$3 (3A)
unnamed: R9.2, U4.45 (X1)
unnamed: C10.1, L3.2, U4.35 (VDDIO)
unnamed: C11.1, U4.32 (VDD1)
unnamed: C12.1, U4.43 (VDD2)
unnamed: C13.1, L4.2, U4.11 (VDDA)
unnamed: R3.1, U4.3 (XRS#)
unnamed: R7.1, S1.P$1 (1A)
unnamed: R8.1, S1.P$2 (2A)
PMON: J4.P$9 (9)
PROCHOT: J4.P$4 (4)
SCI_RX: J3.P$4 (4), U4.48 (GPIO28/SCIRXDA/SDAA/TZ2#)
SCI_TX: J3.P$2 (2), U4.1 (GPIO29/SCITXDA/SCLA/TX3#)
SCL: J4.P$2 (2)
SDA: J4.P$3 (3)
SMBC: J4.P$8 (8)
SMBD: J4.P$7 (7)
SYS_PRES: J4.P$6 (6)
TCK: J3.P$7 (7), U4.23 (TCK)
TD1: U4.20 (TDI)
TDI: J3.P$6 (6)
TDO: J3.P$3 (3), R5.2, S1.P$7 (2B), U4.22 (TDO)
TMS: J3.P$5 (5), U4.21 (TMS)
TRST: R6.2, S1.P$6 (3B), U4.2 (TRST#)

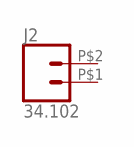
[picture p26: schematic Top PCB1.sch, sheet 5]

Parts:
J2: 34.102

Board: 2 copper layers, 50 parts (0 on the bottom side), 39 nets, no tracks yet.
