ETechZone/Smart-Power-Bank/PCBfiles/BMS.brd

## EAGLE design PCBfiles/BMS.brd (2019-07-17)

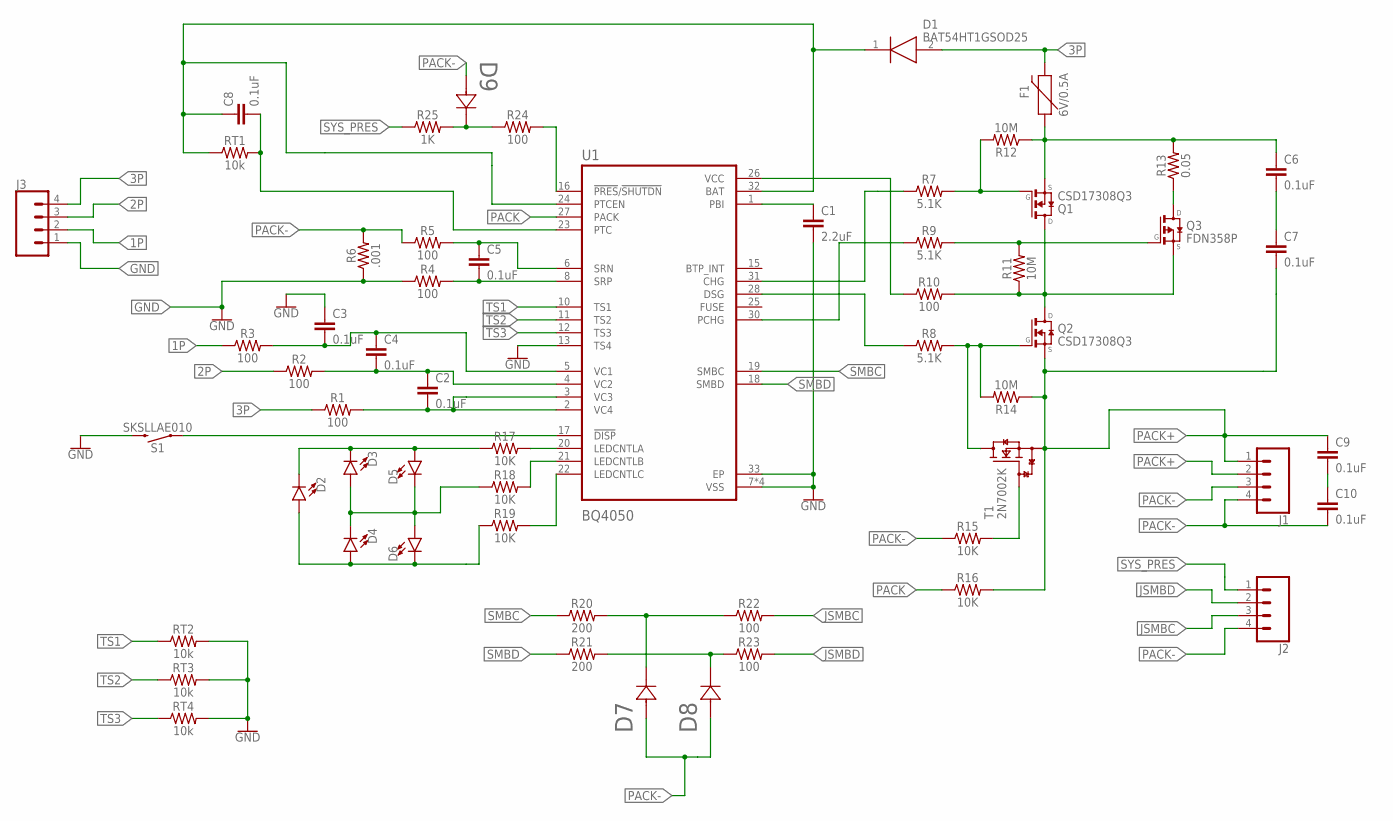
[picture p27: schematic BMS.sch, Battery BMS Section]

Parts:
C1: 2.2uF; 0402-CAP
C2, C3, C4, C5, C6, C7, C8, C9, C10: 0.1uF; 0402
D1: BAT54HT1GSOD25; SOD2512X100
D2, D3, D4, D5, D6: LTW-S272TLA-1175391
D7: D7; SODFL2513X100
D8: D8; SODFL2513X100
D9: D9; SODFL2513X100
F1: 6V/0.5A; 1206
J1, J2: CONN_041.3HOLE; 1X04_1.3HOLE
J3: CONN_041X04_NO_SILK; 1X04_NO_SILK
Q1, Q2: CSD17308Q3; SON8-Q3
Q3: FDN358P; SSOT-3
R1, R2, R3, R4, R5, R10, R22, R23, R24: 100; 0402
R6: .001; RESC3015X65
R7, R8, R9: 5.1K; 0402
R11, R12, R14: 10M; 0402
R13: 0.05; 2512
R15, R16, R17, R18, R19: 10K; 0402
R20, R21: 200; 0402
R25: 1K; 0402
RT1: 10k; 1206
RT2, RT3, RT4: 10k; NTC-RESISTOR
S1: SKSLLAE010; SWITCH
T1: 2N7002K; SOT23
U1: BQ4050; QFN40P400X400X100-33T140

Connections:
1P: J3.2, R3.1
2P: J3.3, R2.1
3P: D1.2 (A), F1.2, J3.4, R1.1
GND: C1.2, C3.1, J3.1, R4.1, R6.1, RT2.2, RT3.2, RT4.2, S1.P$2 (2), U1.7 (VSS), U1.9 (VSS), U1.13 (TS4), U1.14 (VSS), U1.29 (VSS), U1.33 (EP)
JSMBC: J2.3, R22.2
JSMBD: J2.2, R23.2
unnamed: C1.1, U1.1 (PBI)
unnamed: C5.2, R4.2, U1.8 (SRP)
unnamed: S1.P$1 (1), U1.17 (!DISP)
unnamed: C3.2, C4.1, R3.2, U1.5 (VC1)
unnamed: C2.2, R1.2, U1.2 (VC4), U1.3 (VC3)
unnamed: C5.1, R5.2, U1.6 (SRN)
unnamed: C2.1, C4.2, R2.2, U1.4 (VC2)
unnamed: Q1.4 (G), R7.2, R12.2
unnamed: R7.1, U1.31 (CHG)
unnamed: R8.1, U1.28 (DSG)
unnamed: Q2.4 (G), R8.2, R14.2, T1.3 (D)
unnamed: Q1.5 (D), Q1.6 (D), Q1.7 (D), Q1.8 (D), Q2.5 (D), Q2.6 (D), Q2.7 (D), Q2.8 (D), Q3.2 (S), R10.2, R11.1
unnamed: R10.1, U1.26 (VCC)
unnamed: R9.1, U1.30 (PCHG)
unnamed: Q3.1 (G), R9.2, R11.2
unnamed: Q3.3 (D), R13.P$1 (1)
unnamed: R15.2, T1.1 (G)
unnamed: C6.2, C7.1
unnamed: R17.2, U1.20 (LEDCNTLA)
unnamed: D2.P$1 (C), D3.P$1 (C), D5.P$2 (A), R17.1
unnamed: D2.P$2 (A), D4.P$2 (A), D6.P$1 (C), R19.1
unnamed: R19.2, U1.22 (LEDCNTLC)
unnamed: R18.2, U1.21 (LEDCNTLB)
unnamed: D3.P$2 (A), D4.P$1 (C), D5.P$1 (C), D6.P$2 (A), R18.1
unnamed: D7.1, R20.2, R22.1
unnamed: D8.1, R21.2, R23.1
unnamed: C9.2, C10.1
unnamed: C6.1, F1.1, Q1.1 (S), Q1.2 (S), Q1.3 (S), R12.1, R13.P$2 (2)
unnamed: R24.2, U1.16 (!PRES!/!SHUTDN)
unnamed: D9.1, R24.1, R25.2
unnamed: C8.2, RT1.2, U1.23 (PTC)
unnamed: C8.1, D1.1 (K), RT1.1, U1.24 (PTCEN), U1.32 (BAT)
PACK: R16.1, U1.27 (PACK)
PACK+: C7.2, C9.1, J1.1, J1.2, Q2.1 (S), Q2.2 (S), Q2.3 (S), R14.1, R16.2, T1.2 (S)
PACK-: C10.2, D7.2, D8.2, D9.2, J1.3, J1.4, J2.4, R5.1, R6.2, R15.1
SMBC: R20.1, U1.19 (SMBC)
SMBD: R21.1, U1.18 (SMBD)
SYS_PRES: J2.1, R25.1
TS1: RT2.1, U1.10 (TS1)
TS2: RT3.1, U1.11 (TS2)
TS3: RT4.1, U1.12 (TS3)

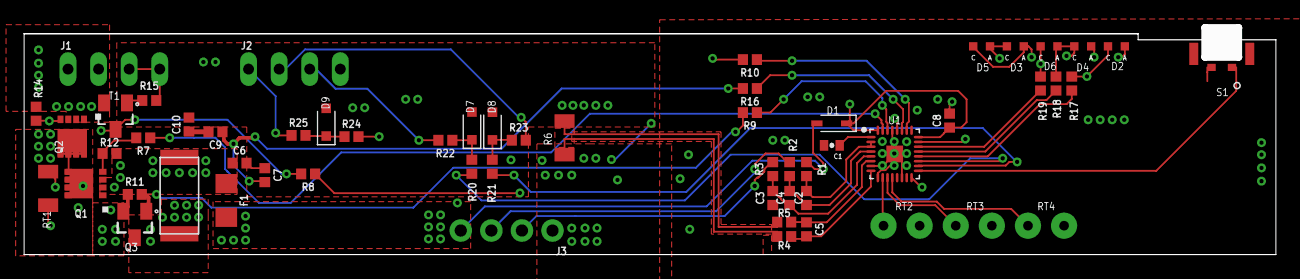
[picture p28: board BMS.brd from above]

Board: 4 copper layers, 104.0 x 18.4 mm, 58 parts (0 on the bottom side), 47 nets.
