ETechZone/Smart-Power-Bank/Programming/cfiles/settings.c

/* 
************************* C file for Display Icon status*****************************
*/

//##############################################################
//       File Name : settings.c
//       
//       TITLE     : Sh1106 oled with c2000(F28027)
//       
//       Development Kit : LAUNCHXL F28027
// 
//       Date Of Created : 03/05/2019 
//###############################################################
//
// Included Files
//

#include<settings.h>
#include <stdio.h>
#include <string.h>
#include <stdint.h>
#include "Sh1106_Oled.h"
#include<icon.h>
//
// Global variables
//
union Screen sett_src;
int scr_var123=0x00;
//*********************************************************************************************
//Function Name    : void ScreenInit(Uint8 i)
//No.Of Parameters : 1
//Parameters Type  : Uint8(unsigned char)
//Return Type      : void
//Description      : To initialize Screen status
//**********************************************************************************************
//
void SETTINGS_ScreenInit(){
    sett_src.status =0x00;
}
//
//*********************************************************************************************
//Function Name    : Uint8 Get_SETTINGS_Screen_val()
//No.Of Parameters : 0
//Parameters Type  : NA
//Return Type      : Uint8
//Description      : To Get global status of screen
//**********************************************************************************************
//
Uint8 Get_SETTINGS_Screen_val(){
    return sett_src.status;
}

//
//*********************************************************************************************
//Function Name    : void SETTINGS_DOWN_update()
//No.Of Parameters : 0
//Parameters Type  : NA
//Return Type      : Uint8
//Description      : To Get global status of screen
//**********************************************************************************************
//
void SETTINGS_DOWN_update(){
    Uint8 i;
    i=Get_SETTINGS_Screen_val();
    i++;
    if(Get_SETTINGS_Screen_val()!=0x04)
    sett_src.status=i;
}
//
//*********************************************************************************************
//Function Name    : void SETTINGS_DOWN_update()
//No.Of Parameters : 0
//Parameters Type  : NA
//Return Type      : Uint8
//Description      : To Get global status of screen
//**********************************************************************************************
//
void SETTINGS_UP_update(){
Uint8 i;
i=Get_SETTINGS_Screen_val();
i--;
if(Get_SETTINGS_Screen_val()!=0x00)
   sett_src.status=i;
}
//
//*********************************************************************************************
//Function Name    : Uint8* AC_bitmap()
//No.Of Parameters : 0
//Parameters Type  : NA
//Return Type      : Uint8*
//Description      : To get bitmap of the AC related bitmap of the setting screen
//**********************************************************************************************
//


void Icon_Update_Status1(Uint8 i){
    if(scr_var123==i){
        scr_var123=0;
    }else {
    scr_var123=i;
    }
}
Uint8 Icon_Read_Status1(){
    return scr_var123;
}
void AC_bitmap(unsigned int i){
    Uint8 j;
    const Uint8 *ac_ptr;
    //
    // AC logo on and option highlighted
    //
    const Uint8 ac_high_on[]={
    0x00, 0x00, 0x00, 0x00, 0x00, 0x00, 0x00, 0x00, 0xC0, 0x20, 0x20, 0xC0, 0x00, 0xC0, 0x20, 0x20,
    0x20, 0x00, 0x00, 0x00, 0x00, 0x00, 0x00, 0x00, 0x00, 0x00, 0x00, 0x00, 0x00, 0x00, 0x00, 0x00,
    0x00, 0x00, 0x00, 0x00, 0x00, 0x00, 0x00, 0x00, 0x00, 0x00, 0x00, 0x00, 0x00, 0x00, 0x00, 0x00,
    0x00, 0x00, 0x00, 0x00, 0x00, 0x00, 0x00, 0x00, 0x00, 0x00, 0x00, 0x00, 0x00, 0x00, 0x00, 0x00,
    0x00, 0x00, 0x00, 0x00, 0x00, 0x00, 0x00, 0x00, 0x00, 0x00, 0x00, 0x00, 0x00, 0x00, 0x00, 0x00,
    0x00, 0x00, 0x00, 0x00, 0x00, 0x00, 0x00, 0x00, 0x00, 0x00, 0x00, 0x00, 0x00, 0x00, 0x00, 0x00,
    0x00, 0x00, 0x00, 0x00, 0x00, 0x00, 0x00, 0x00, 0x00, 0x00, 0x00, 0x00, 0x00, 0x00, 0x00, 0x00,
    0xF8, 0xF8, 0x00, 0x00, 0x00, 0x00, 0xF8, 0xF8, 0x00, 0x00, 0x00, 0x00, 0x00, 0x00, 0x00, 0x00,
    0x00, 0x00, 0x00, 0x00, 0x00, 0x00, 0x00, 0x00, 0x0F, 0x01, 0x01, 0x0F, 0x00, 0x07, 0x08, 0x08,
    0x08, 0x00, 0x00, 0x00, 0x00, 0x00, 0x00, 0x00, 0x00, 0x00, 0x00, 0x00, 0x00, 0x00, 0x00, 0x00,
    0x00, 0x00, 0x00, 0x00, 0x00, 0x00, 0x00, 0x00, 0x00, 0x00, 0x00, 0x00, 0x00, 0x00, 0x00, 0x00,
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
    0xFF, 0xFF, 0xFF, 0xFF, 0xFF, 0xFF, 0xFF, 0xFF, 0xFF, 0xFF, 0xFF, 0xFF, 0xFF, 0xFF, 0xFF, 0xFF,
    0xFF, 0xFF, 0xFF, 0xFF, 0xFF, 0xFF, 0xFF, 0xFF, 0xFF, 0xFF, 0xFF, 0xFF, 0xFF, 0xFF, 0xFF, 0xFF,
    0xFF, 0xFF, 0xFF, 0xFF, 0xFF, 0xFF, 0xFF, 0xFF, 0xFF, 0xFF, 0xFF, 0xFF, 0xFF, 0xFF, 0xFF, 0xFF,
    0xFF, 0xFF, 0xFF, 0xFF, 0xFF, 0xFF, 0xFF, 0xFF, 0xFF, 0xFF, 0xFF, 0xFF, 0xFF, 0xFF, 0xFF, 0xFF
    };

    if(Get_SETTINGS_Screen_val()==0x04){
              for(j=0;j<256;j++){
                  exit_invert[j]=Byte_Invert(exit_low[j]);
              }
                exit_ptr= &exit_invert[0];
            }
            else{
                exit_ptr= &exit_low[0];
            }
         for(j=0;j<256;j++,i++){
             Current_Screen[i] = *(exit_ptr+j);
                }
}
//
//*********************************************************************************************
//Function Name    : void Blank_bitmap(unsigned int i)
//No.Of Parameters : 1
//Parameters Type  : unsigned int
//Return Type      : void
//Description      :
//**********************************************************************************************
//
/*
void Blank_bitmap(unsigned int i){
    //
    // Blank screen bmps
    //
    Uint8 j;

    for(j=0;j<256;j++,i++){
        Current_Screen[i] = 0xFF;
    }
}
*/
//
//*********************************************************************************************
//Function Name    : void Settings_bitmap(unsigned int i)
//No.Of Parameters : 0
//Parameters Type  : NA
//Return Type      : Uint8*
//Description      : To get bitmap of the exit part of the setting screen
//**********************************************************************************************
//
void Settings_bitmap(unsigned int i){
    Uint8 j;
    Uint8 settings[]={
        0xFF, 0xFF, 0xFF, 0xFF, 0xFF, 0xFF, 0xFF, 0xFF, 0xFF, 0xFF, 0xFF, 0xFF, 0xFF, 0xFF, 0xFF, 0xFF,
        0xFF, 0xFF, 0xFF, 0xFF, 0xFF, 0xFF, 0xFF, 0xFF, 0xFF, 0xFF, 0xFF, 0xFF, 0xFF, 0xFF, 0xFF, 0xFF,
        0xFF, 0xFF, 0xFF, 0xFF, 0xFF, 0xFF, 0xFF, 0xFF, 0xFF, 0xFF, 0xFF, 0xFF, 0x9F, 0x6F, 0x6F, 0xDF,
        0xFF, 0x0F, 0x6F, 0x6F, 0xEF, 0xFF, 0xEF, 0xEF, 0x0F, 0xEF, 0xEF, 0xFF, 0xEF, 0xEF, 0x0F, 0xEF,
        0xEF, 0xFF, 0xEF, 0x0F, 0xEF, 0xFF, 0x0F, 0xDF, 0xBF, 0x0F, 0xFF, 0x1F, 0xEF, 0xEF, 0xDF, 0xFF,
        0x9F, 0x6F, 0x6F, 0xDF, 0xFF, 0xFF, 0xFF, 0xFF, 0xFF, 0xFF, 0xFF, 0xFF, 0xFF, 0xFF, 0xFF, 0xFF,
        0xFF, 0xFF, 0xFF, 0xFF, 0xFF, 0xFF, 0xFF, 0xFF, 0xFF, 0xFF, 0xFF, 0xFF, 0xFF, 0xFF, 0xFF, 0xFF,
        0xFF, 0xFF, 0xFF, 0xFF, 0xFF, 0xFF, 0xFF, 0xFF, 0xFF, 0xFF, 0xFF, 0xFF, 0xFF, 0xFF, 0xFF, 0xFF,
        0xFF, 0xFF, 0xFF, 0xFF, 0xFF, 0xFF, 0xFF, 0xFF, 0xFF, 0xFF, 0xFF, 0xFF, 0xFF, 0xFF, 0xFF, 0xFF,
        0xFF, 0xFF, 0xFF, 0xFF, 0xFF, 0xFF, 0xFF, 0xFF, 0xFF, 0xFF, 0xFF, 0xFF, 0xFF, 0xFF, 0xFF, 0xFF,
        0xFF, 0xFF, 0xFF, 0xFF, 0xFF, 0xFF, 0xFF, 0xFF, 0xFF, 0xFF, 0xFF, 0xFF, 0xFD, 0xFB, 0xFB, 0xFC,
        0xFF, 0xF8, 0xFB, 0xFB, 0xFB, 0xFF, 0xFF, 0xFF, 0xF8, 0xFF, 0xFF, 0xFF, 0xFF, 0xFF, 0xF8, 0xFF,
        0xFF, 0xFF, 0xFB, 0xF8, 0xFB, 0xFF, 0xF8, 0xFF, 0xFF, 0xF8, 0xFF, 0xFC, 0xFB, 0xFA, 0xF8, 0xFF,
        0xFD, 0xFB, 0xFB, 0xFC, 0xFF, 0xFF, 0xFF, 0xFF, 0xFF, 0xFF, 0xFF, 0xFF, 0xFF, 0xFF, 0xFF, 0xFF,
        0xFF, 0xFF, 0xFF, 0xFF, 0xFF, 0xFF, 0xFF, 0xFF, 0xFF, 0xFF, 0xFF, 0xFF, 0xFF, 0xFF, 0xFF, 0xFF,
        0xFF, 0xFF, 0xFF, 0xFF, 0xFF, 0xFF, 0xFF, 0xFF, 0xFF, 0xFF, 0xFF, 0xFF, 0xFF, 0xFF, 0xFF, 0xFF
        };
    for(j=i;j<256;j++,i++){
        Current_Screen[i]=settings[j];     // putting the settings bitmap into entire screen map
            }
}

void sett_blank(unsigned int i){
    Uint8 j;
    for(j=0;j<256;j++,i++){
        Current_Screen[i]=0xFF;
    }
}

//
//*********************************************************************************************
//Function Name    : Uint8* Settings_Get_Bitmap()
//No.Of Parameters : 0
//Parameters Type  : NA
//Return Type      : Uint8*
//Description      : To get bitmap of the settings screen
//**********************************************************************************************
//
Uint8* Settings_Get_Bitmap(){
    //
    // settings bmps
    //

    Current_Screen_ptr=&Current_Screen[0];// initializing the pointer with base address of array
    Settings_bitmap(0);
    switch(Get_SETTINGS_Screen_val()){     // switch case
        case 0x01:{
            HUB_bitmap(256);
            if(Icon_Read_Status1()==0x00){
                PASS_bitmap(512,0); // new
                        }else{
                PASS_bitmap(512,1); // new
                        }

            BC_bitmap(768);     // new
         //   BC_bitmap(512);//BR_bitmap();
          // BR_bitmap(768);//BC_bitmap();
            break;
        }
        case 0x02:{
            if(Icon_Read_Status1()==0x00){
            PASS_bitmap(256,0); // new
            }else{
                PASS_bitmap(256,1); // new
            }
            BC_bitmap(512);//new
            Exit_bitmap(768);//new
           // BR_bitmap(768);//new
            //BC_bitmap(256);//
           // BR_bitmap(512);//
            //Exit_bitmap(768);//Exit_bitmap();
            break;
        }
        case 0x03:{
            BC_bitmap(256);//new
            //BR_bitmap(512);//new
            Exit_bitmap(512);//new
            sett_blank(768);// new
            // BR_bitmap(256);
             //Exit_bitmap(512);
             //sett_blank(768); // available on icon.h
             break;
        }
        case 0x04:{
            Exit_bitmap(256);//new
            sett_blank(512);// new
            sett_blank(768);// new
             //Exit_bitmap(256);//Exit_bitmap();
             //sett_blank(512);      //available on icon.h
             //sett_blank(768);      //available on icon.h
              break;
        }
        default :{
            AC_bitmap(256);
            HUB_bitmap(512);
            if(Icon_Read_Status1()==0x00){
                        PASS_bitmap(768,0); // new
                        }else{
                            PASS_bitmap(768,1); // new
                        }
            //BC_bitmap(768);
              break;
        }
    }
    return Current_Screen_ptr;

}

//End of file
//
