ETechZone/Smart-Power-Bank/(commit log)

2019-07-15 sample commit
2019-07-17 PCB files
    [B PCB.brd, B PCB.sch, B PCB1.brd, B PCB1.sch, Conn_pcb.brd, Conn_pcb.sch, Conn_pcb1.brd, Conn_pcb1.sch]
